auomoto/BOSS-RoboClaw-Interface/README.md

# BOSS-RoboClaw-Interface
 
Interface board that sits on top of the RoboClaw 2x7A controller with a connector for a PI motor.
