auomoto/BOSS-RoboClaw-Interface/Hardware/Eagle/BOSS-RoboClaw-Interface.pdf

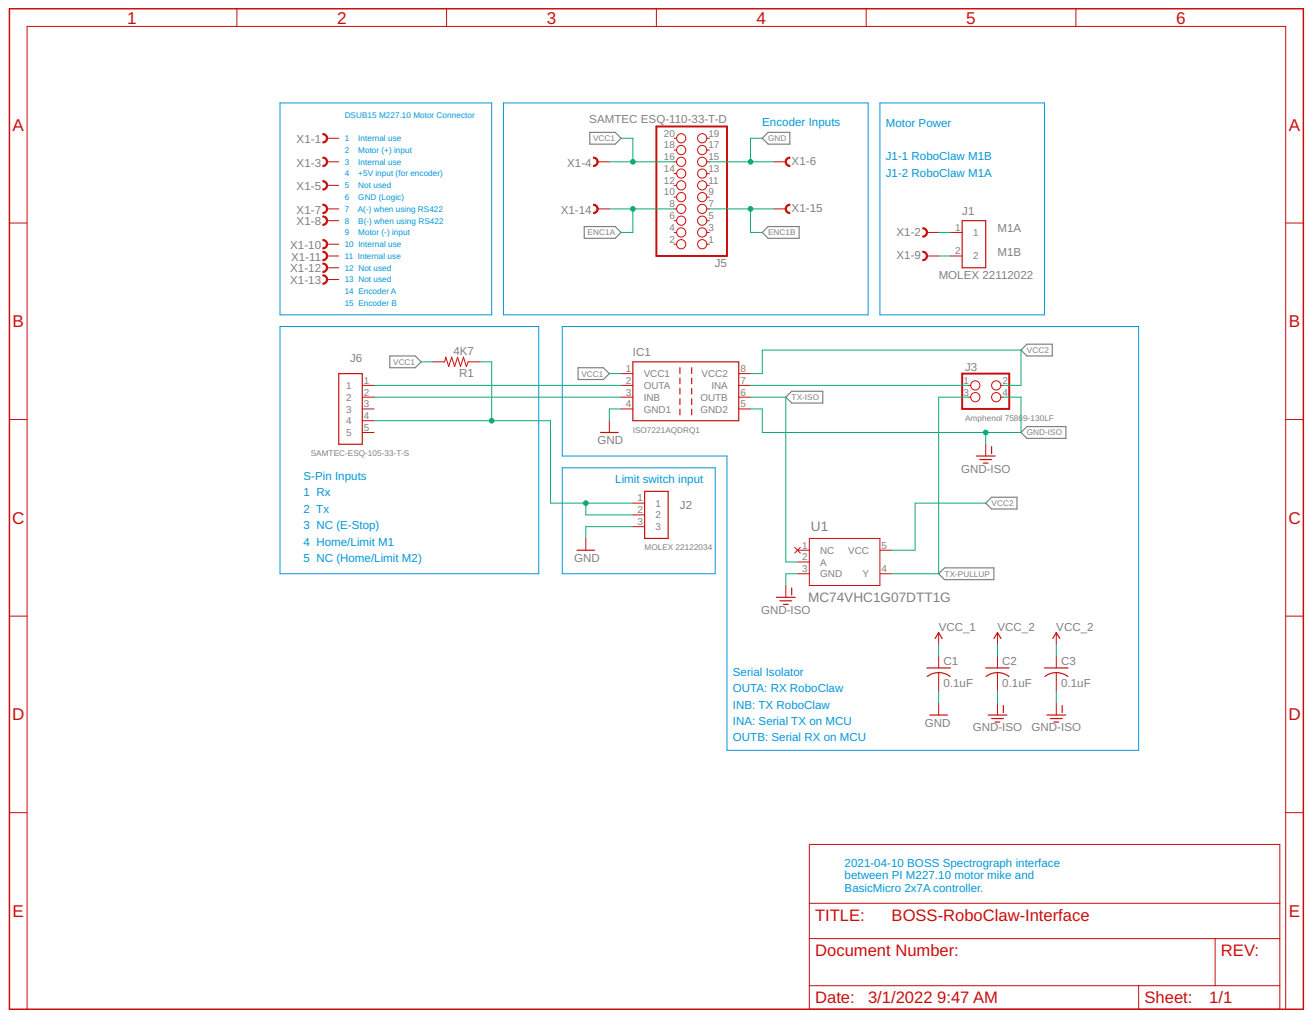
[picture p1: page 1]

Serial Isolator OUTA: RX RoboClaw

INB: TX RoboClaw
INA: Serial TX on MCU
OUTB: Serial RX on MCU

2021-04-10 BOSS Spectrograph interface
between PI M227.10 motor mike and
BasicMicro 2x7A controller.
TITLE:

Document Number: | REV:

Date: 3/1/2022 9:47 AM | Sheet: 1/1
