auomoto/BOSS-RoboClaw-Interface/Hardware/Eagle/2021-04-10 BOSS-RoboClaw-Interface.pdf

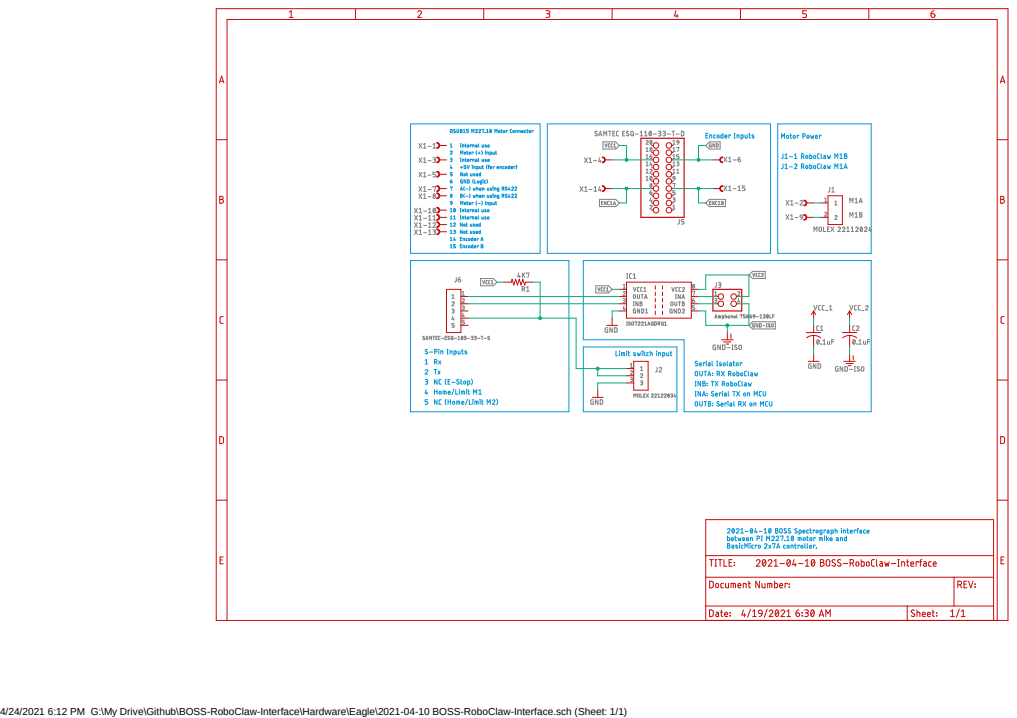
[picture p2: page 1]

4/24/2021 6:12 PM G:\My Drive\Github\BOSS-RoboClaw-Interface\Hardware\Eagle\2021-04-10 BOSS-RoboClaw-Interface.sch (Sheet: 1/1)
