auomoto/BOSS-RoboClaw-Interface/Hardware/Eagle/2020-11-23 BOSS-RoboClaw-Interface Schematic.pdf

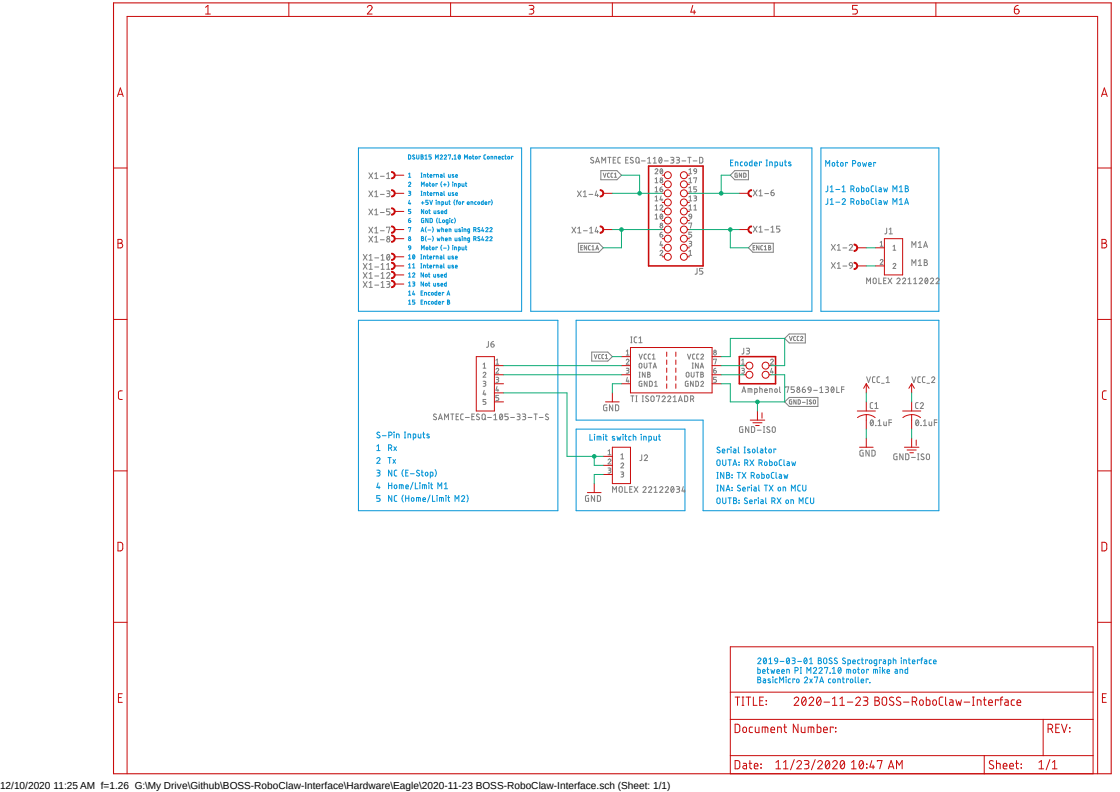
[picture p3: page 1]

12/10/2020 11:25 AM f=1.26 G:\My Drive\Github\BOSS-RoboClaw-Interface\Hardware\Eagle\2020-11-23 BOSS-RoboClaw-Interface.sch (Sheet: 1/1)
