auomoto/BOSS-RoboClaw-Interface/Hardware/Eagle/BOSS-RoboClaw-Interface.brd

## EAGLE design Hardware/Eagle/BOSS-RoboClaw-Interface.brd (2022-06-14)

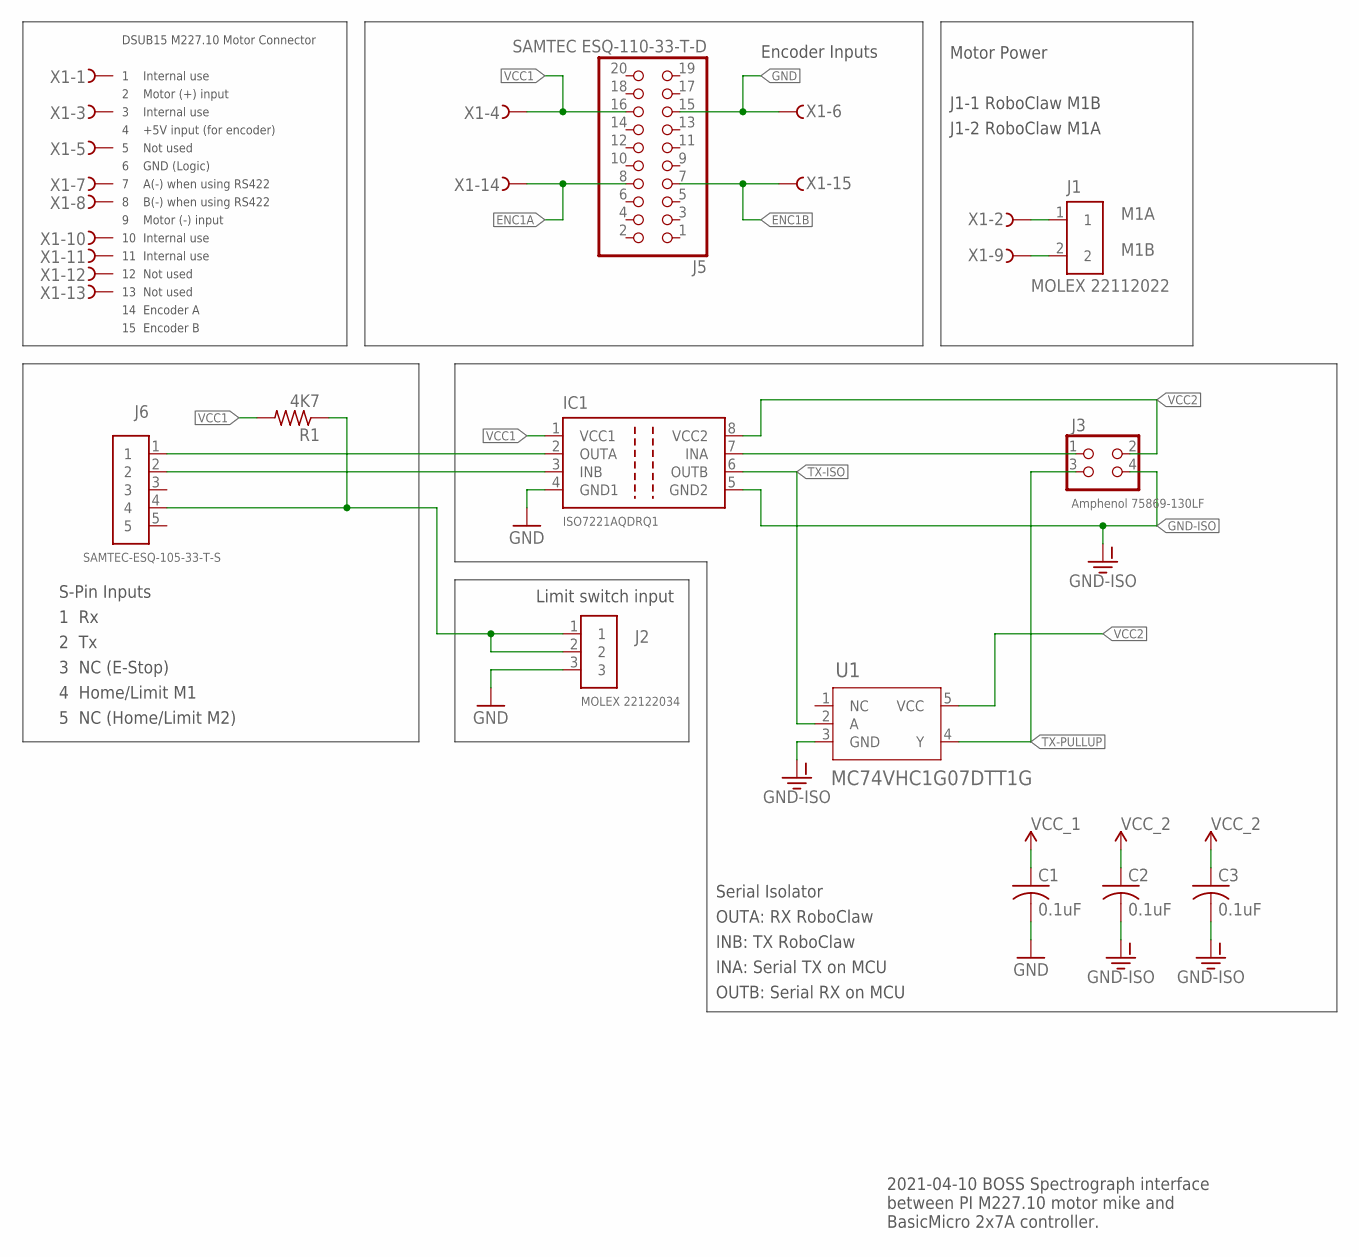
[picture p4: schematic BOSS-RoboClaw-Interface.sch]

Parts:
C1, C2, C3: 0.1uF; C0805
IC1: ISO7221AQDRQ1; SO-08-ISO7221
J1: MOLEX 22112022; 1X02-MOLEX-22112022
J2: MOLEX 22122034; 1X03RA-MOLEX-22122034
J3: Amphenol 75869-130LF; 2X02-SHROUD
J5: SAMTEC ESQ-110-33-T-D; 2X10-ESQ-110-33-T-D
J6: SAMTEC-ESQ-105-33-T-S; 1X05-ESQ-105-33-T-S
R1: 4K7; R0805
U1: MC74VHC1G07DTT1G; SOT23-5_ONS-M
X1: Amphenol L77SDAH15SOL2RM8C309; H2R15ST

Connections:
ENC1A: J5.8, X1.14
ENC1B: J5.7, X1.15
GND: C1.2, IC1.4 (GND1), J2.3, J5.15, X1.6
GND-ISO: C2.2, C3.2, IC1.5 (GND2), J3.4, U1.3 (GND)
LIMIT: J2.1, J2.2, J6.4, R1.1
M1A: J1.1, X1.2
M1B: J1.2, X1.9
ROBO-RX: IC1.2 (OUTA), J6.1
ROBO-TX: IC1.3 (INB), J6.2
RX: IC1.7 (INA), J3.1
TX-ISO: IC1.6 (OUTB), U1.2 (A)
TX-PULLUP: J3.3, U1.4 (Y)
VCC1: C1.1, IC1.1 (VCC1), J5.16, R1.2, X1.4
VCC2: C2.1, C3.1, IC1.8 (VCC2), J3.2, U1.5 (VCC)

Notes on the sheet:
DSUB15 M227.10 Motor Connector 1 Internal use 2 Motor (+) input 3 Internal use 4 +5V input (for encoder) 5 Not used 6 GND (Logic) 7 A(-) when using RS422 8 B(-) when using RS422 9 Motor (-) input 10 Internal use 11 Internal use 12 Not used 13 Not used 14 Encoder A 15 Encoder B
Motor Power J1-1 RoboClaw M1B J1-2 RoboClaw M1A
Limit switch input
S-Pin Inputs 1 Rx 2 Tx 3 NC (E-Stop) 4 Home/Limit M1 5 NC (Home/Limit M2)
Serial Isolator OUTA: RX RoboClaw INB: TX RoboClaw INA: Serial TX on MCU OUTB: Serial RX on MCU
Encoder Inputs
2021-04-10 BOSS Spectrograph interface between PI M227.10 motor mike and BasicMicro 2x7A controller.

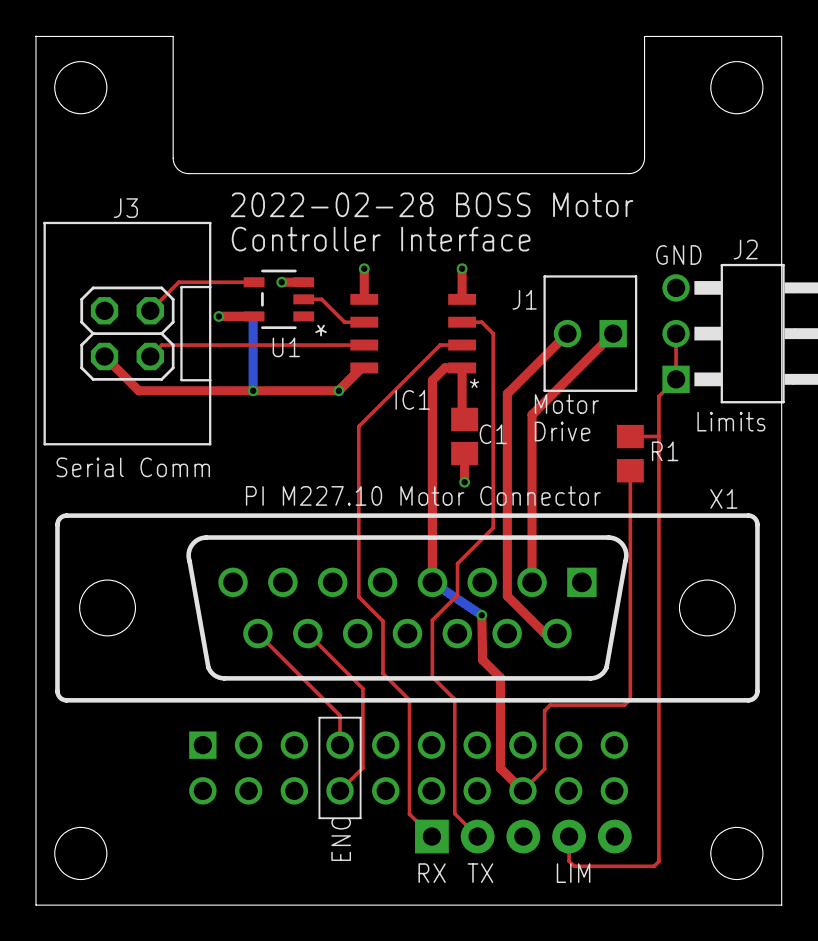
[picture p5: board BOSS-RoboClaw-Interface.brd from above]

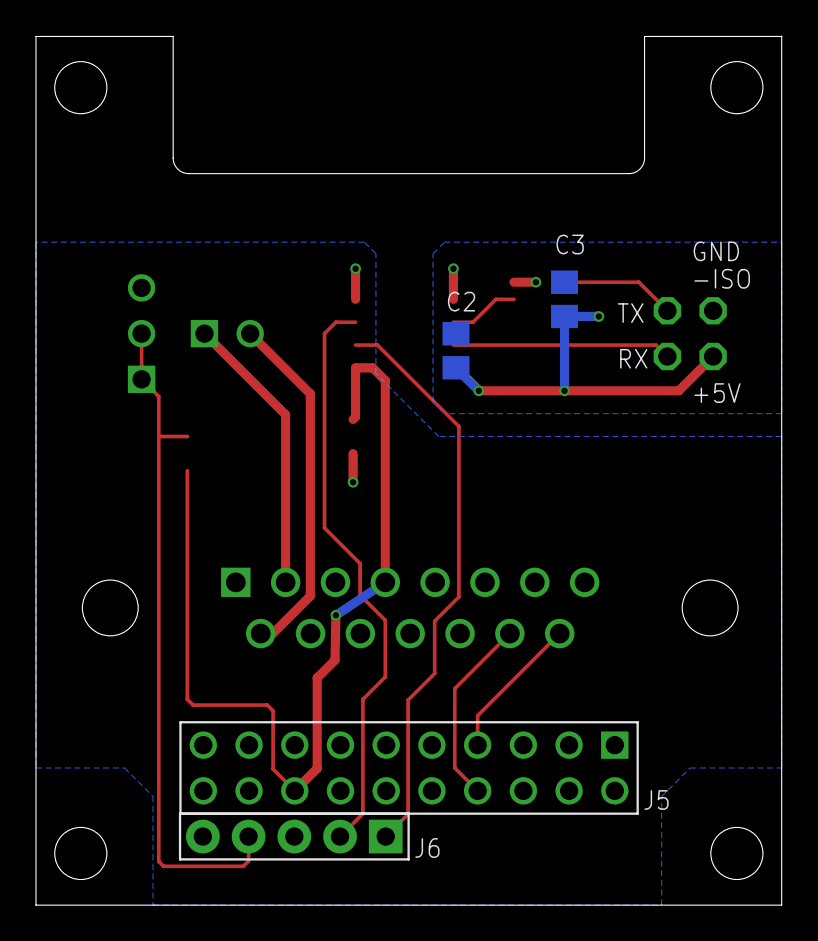
[picture p6: board BOSS-RoboClaw-Interface.brd from below]

Board: 2 copper layers, 41.4 x 48.3 mm, 12 parts (4 on the bottom side), 14 nets.
