auomoto/BOSS-RoboClaw-Interface/Hardware/Eagle/2021-04-16 BOSS-RoboClaw-Breakout.brd

## EAGLE design Hardware/Eagle/2021-04-16 BOSS-RoboClaw-Breakout.brd (2021-04-16)

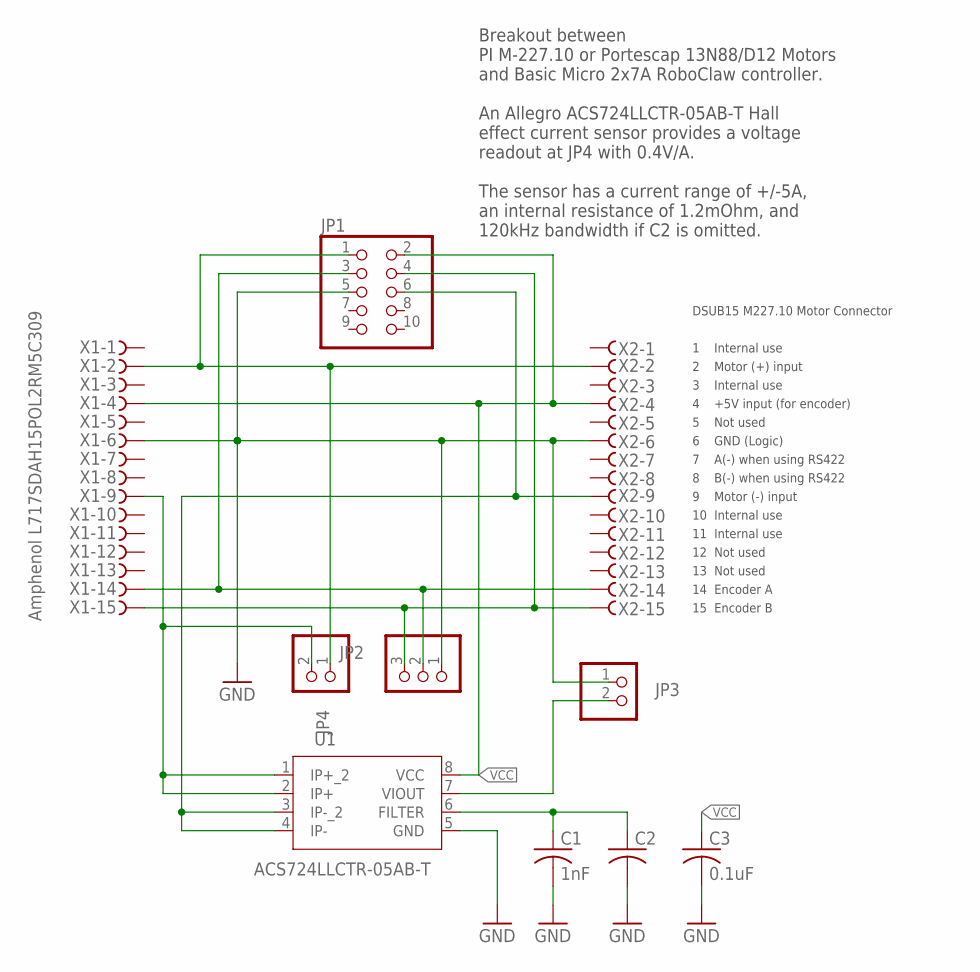
[picture p7: schematic 2021-04-16 BOSS-RoboClaw-Breakout.sch]

Parts:
C1: 1nF; C0805
C2: C-USC0805; C0805
C3: 0.1uF; C0805
JP1: PINHD-2X5; 2X05
JP2: PINHD-1X3; 1X03
JP3, JP4: PINHD-1X2; 1X02
U1: ACS724LLCTR-05AB-T; IC8_ACS724LLCTR-05AB-T_ALM
X1: Amphenol L717SDAH15POL2RM5C309; H2M15ST
X2: Amphenol L77SDAH15SOL2RM8C309; H2R15ST

Connections:
ENCA: JP1.3, JP2.2, X1.14, X2.14
ENCB: JP1.4, JP2.3, X1.15, X2.15
FILTER: C1.1, C2.1, U1.6 (FILTER)
GND: C1.2, C2.2, C3.2, JP1.5, JP2.1, JP3.1, U1.5 (GND), X1.6, X2.6
M+: JP1.1, JP4.1, X1.2, X2.2
M-: JP1.6, U1.3 (IP-_2), U1.4 (IP-), X2.9
unnamed: JP4.2, U1.1 (IP+_2), U1.2 (IP+), X1.9
VCC: C3.1, JP1.2, U1.8 (VCC), X1.4, X2.4
VIOUT: JP3.2, U1.7 (VIOUT)

Notes on the sheet:
DSUB15 M227.10 Motor Connector 1 Internal use 2 Motor (+) input 3 Internal use 4 +5V input (for encoder) 5 Not used 6 GND (Logic) 7 A(-) when using RS422 8 B(-) when using RS422 9 Motor (-) input 10 Internal use 11 Internal use 12 Not used 13 Not used 14 Encoder A 15 Encoder B
Breakout between PI M-227.10 or Portescap 13N88/D12 Motors and Basic Micro 2x7A RoboClaw controller. An Allegro ACS724LLCTR-05AB-T Hall effect current sensor provides a voltage readout at JP4 with 0.4V/A. The sensor has a current range of +/-5A, an internal resistance of 1.2mOhm, and 120kHz bandwid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

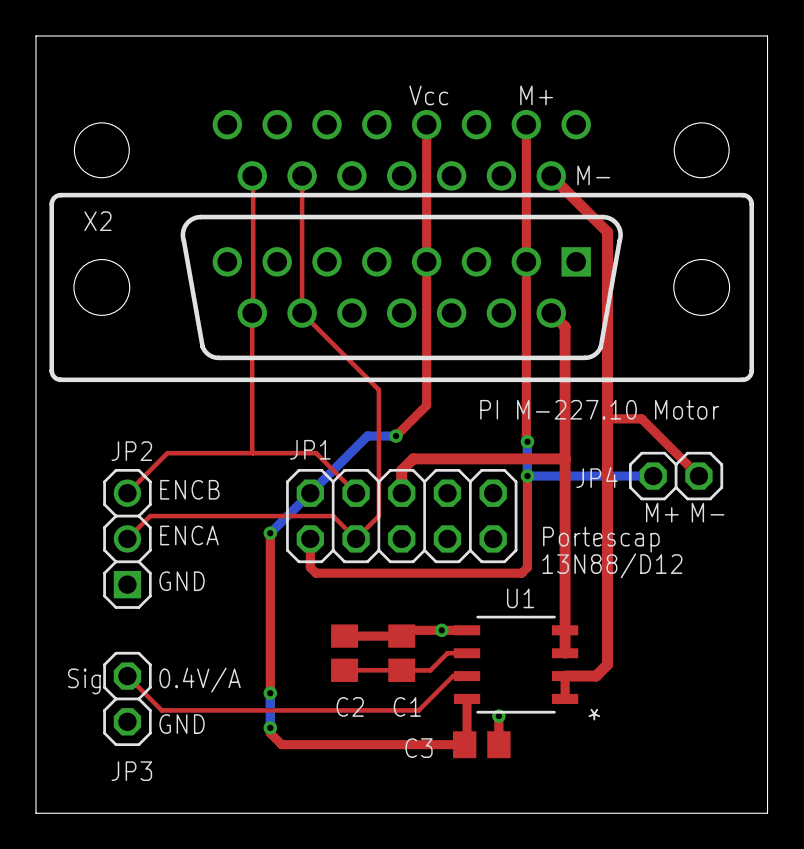
[picture p8: board 2021-04-16 BOSS-RoboClaw-Breakout.brd from above]

Board: 2 copper layers, 40.6 x 43.2 mm, 10 parts (1 on the bottom side), 9 nets.
