auomoto/BOSS-RoboClaw-Interface/Hardware/Eagle/2021-04-14 BOSS-RoboClaw-Breakout.brd

## EAGLE design Hardware/Eagle/2021-04-14 BOSS-RoboClaw-Breakout.brd (2021-04-15)

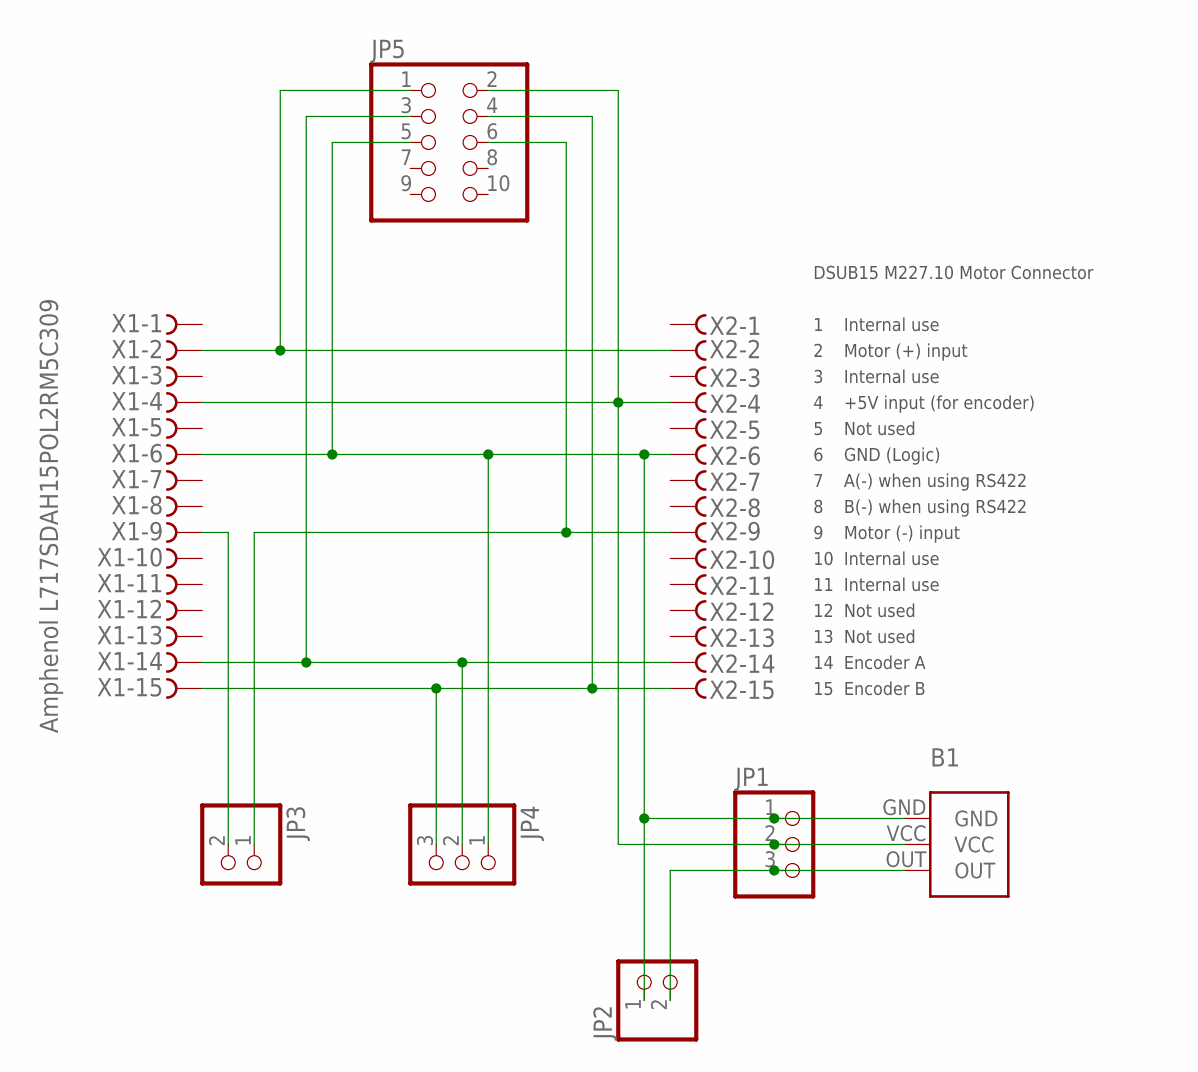
[picture p9: schematic 2021-04-14 BOSS-RoboClaw-Breakout.sch]

Parts:
B1: ACS724CARRIER
JP1, JP4: PINHD-1X3; 1X03
JP2, JP3: PINHD-1X2; 1X02
JP5: PINHD-2X5; 2X05
X1: Amphenol L717SDAH15POL2RM5C309; H2M15ST
X2: Amphenol L77SDAH15SOL2RM8C309; H2R15ST

Connections:
ENCA: JP4.2, JP5.3, X1.14, X2.14
ENCB: JP4.3, JP5.4, X1.15, X2.15
GND: B1.GND, JP1.1, JP2.1, JP4.1, JP5.5, X1.6, X2.6
M+: JP5.1, X1.2, X2.2
M-: JP3.1, JP5.6, X2.9
unnamed: JP3.2, X1.9
OUT: B1.OUT, JP1.3, JP2.2
VCC: B1.VCC, JP1.2, JP5.2, X1.4, X2.4

Notes on the sheet:
DSUB15 M227.10 Motor Connector 1 Internal use 2 Motor (+) input 3 Internal use 4 +5V input (for encoder) 5 Not used 6 GND (Logic) 7 A(-) when using RS422 8 B(-) when using RS422 9 Motor (-) input 10 Internal use 11 Internal use 12 Not used 13 Not used 14 Encoder A 15 Encoder B

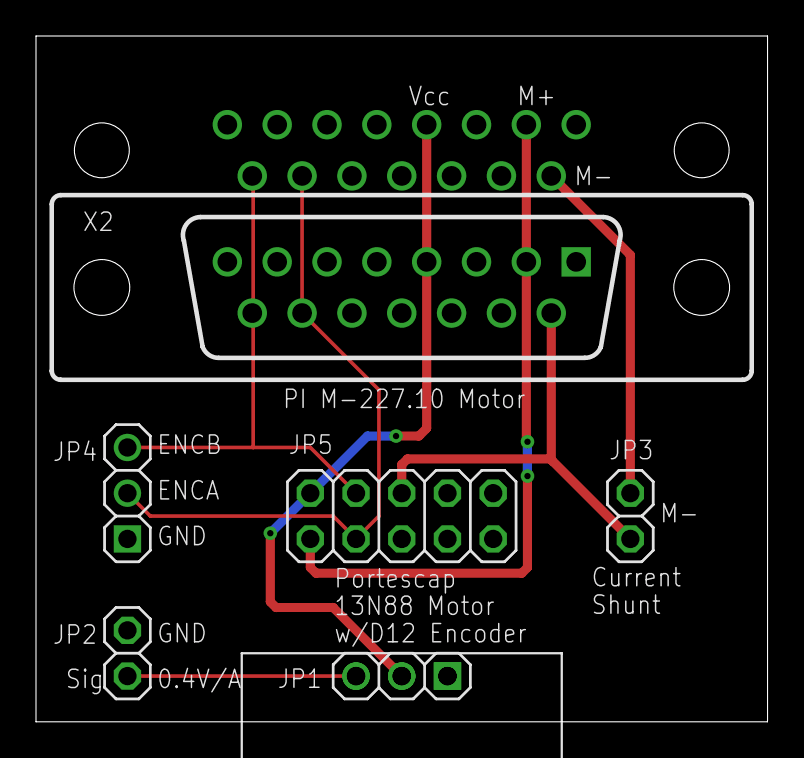
[picture p10: board 2021-04-14 BOSS-RoboClaw-Breakout.brd from above]

Board: 2 copper layers, 40.6 x 38.1 mm, 8 parts (1 on the bottom side), 8 nets.
