auomoto/BOSS-RoboClaw-Interface/Hardware/Eagle/BOSS-RoboClaw-Interface - Copy.brd

## EAGLE design Hardware/Eagle/BOSS-RoboClaw-Interface - Copy.brd (2020-11-21, an earlier design)

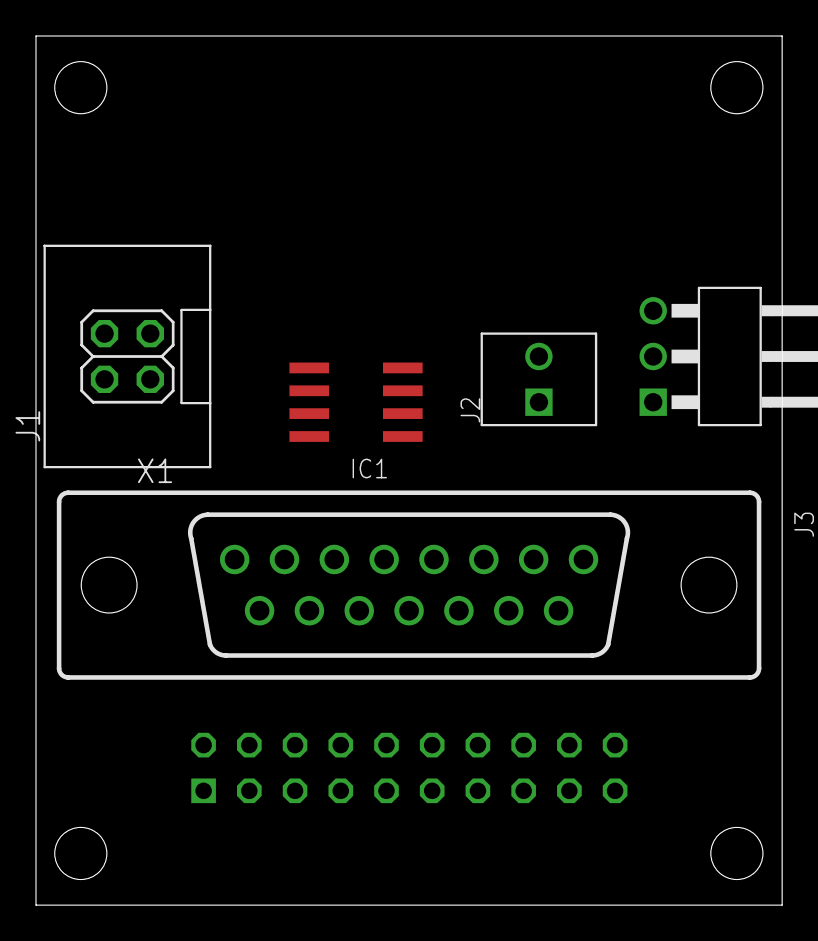
[picture p11: board BOSS-RoboClaw-Interface - Copy.brd from above]

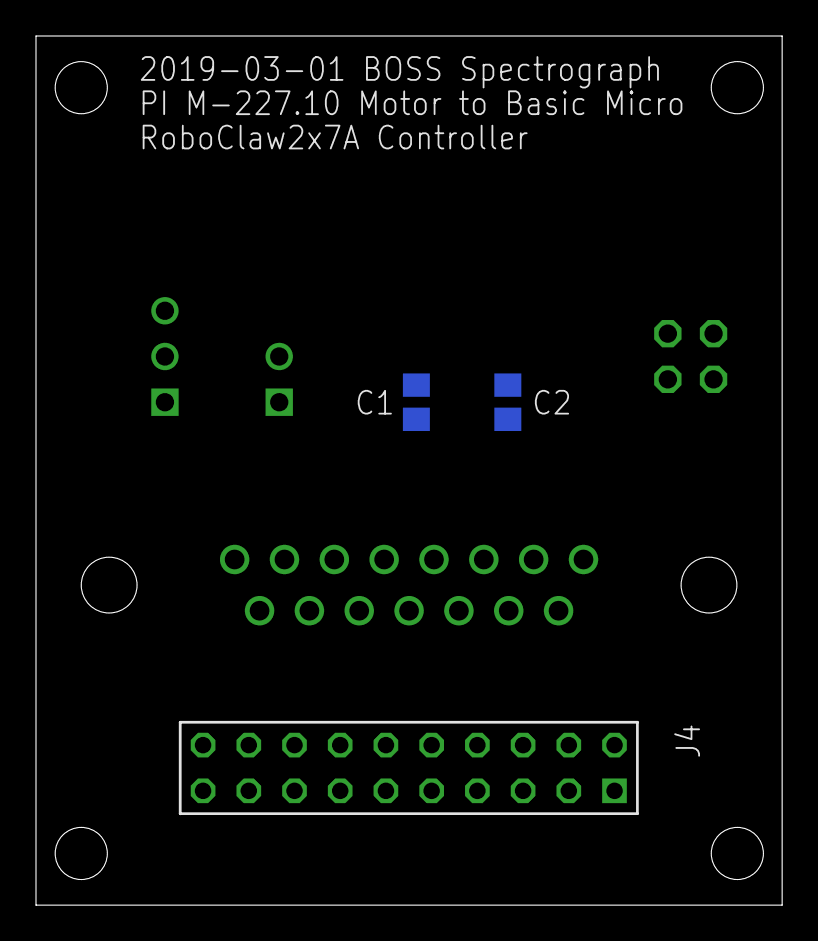
[picture p12: board BOSS-RoboClaw-Interface - Copy.brd from below]

Board: 2 copper layers, 41.5 x 48.3 mm, 8 parts (3 on the bottom side), 9 nets, no tracks yet.

Parts:
C1, C2: 0.1uF; C0805
IC1: ISO7221A; SO-08
J1: 2X02-SHROUD
J2: PINHD-1X2-MOLEX-22112022; 1X02-MOLEX-22112022
J3: Molex 22122034; 1X03RA-MOLEX-22122034
J4: FE10-2-SAMTEC-ESW-110-44-S-D
X1: Amphenol L77SDAH15SOL2RM8C309; H2R15ST

Connections:
GND: C1.2, IC1.4, J3.3, X1.6
GND-ISO: C2.2, IC1.5, J1.4
LIMIT/HOME: J3.1, J3.2
M1A: J2.2, X1.9
M1B: J2.1, X1.2
unnamed: IC1.7, J1.1
unnamed: IC1.6, J1.3
VCC1: C1.1, IC1.1, X1.4
VCC2: C2.1, IC1.8, J1.2
