auomoto/BOSS-RoboClaw-Interface/(commit log)

2020-11-21 Changed connectors and board outline to be able to use existing screw connectors
    [BOSS-RoboClaw-Interface - Copy.brd, BOSS-RoboClaw-Interface - Copy.sch]
2020-11-21 More layout changes
    [BOSS-RoboClaw-Interface.brd, BOSS-RoboClaw-Interface.sch]
2020-11-23 New headers for RoboClaw interface (need to check connections)
    [BOSS-RoboClaw-Interface.brd, BOSS-RoboClaw-Interface.sch]
2020-11-23 Swapped ENC-A and ENC-B pins to be consistent
    Also updated the board labels and changed the date to 2020-11-23.
    [BOSS-RoboClaw-Interface.brd, BOSS-RoboClaw-Interface.sch]
2020-11-23 No changes made; just saved new version
    [BOSS-RoboClaw-Interface.brd, BOSS-RoboClaw-Interface.sch]
2020-11-23 Removed sheet 2 from the schematic (old notes & BOM)
    [BOSS-RoboClaw-Interface.sch]
2020-12-10 Created schematic PDF and saved 2020-11-23 version
    [2020-11-23 BOSS-RoboClaw-Interface.brd, 2020-11-23 BOSS-RoboClaw-Interface.sch]
2021-01-11 Changed isolator chip to ISO7221AQDRQ1 from ISO7221ADR (better stock)
    [BOSS-RoboClaw-Interface.brd, BOSS-RoboClaw-Interface.sch]
2021-02-15 Increased trace width to 0.008 from 0.006 inches
    [BOSS-RoboClaw-Interface.brd]
2021-02-20 Added pullup to limit switch line
    [2021-02-15 BOSS-RoboClaw-Interface.brd, 2021-02-15 BOSS-RoboClaw-Interface.sch]
2021-02-21 Changed limit switch pullup to 4.7K
    [BOSS-RoboClaw-Interface.brd, BOSS-RoboClaw-Interface.sch]
2021-04-15 Created a motor breakout board
    [2021-03-05 RoboClaw Settings.cfg, 2021-03-05a RoboClaw Settings.cfg, 2021-04-14 BOSS-RoboClaw-Breakout.brd, 2021-04-14 BOSS-RoboClaw-Breakout.sch, BOSS-RoboClaw-Breakout.brd, BOSS-RoboClaw-Breakout.sch, BOSS-RoboClaw-Interface.brd, BOSS-RoboClaw-Interface.sch]
2021-04-16 Added motor power header pins
    [2021-04-16 BOSS-RoboClaw-Breakout.brd, 2021-04-16 BOSS-RoboClaw-Breakout.sch]
2021-04-30 Added notes to the breakout board schematic (received the breakout board today)
    [2021-04-10 BOSS-RoboClaw-Interface.brd, 2021-04-10 BOSS-RoboClaw-Interface.sch, BOSS-RoboClaw-Breakout.sch]
2021-05-06 Fixed an error in the schematic notes (J4 is motor voltage)
    [BOSS-RoboClaw-Breakout.sch]
2021-07-24 Create 2021-05-28 RoboClaw Settings.cfg
    [2021-05-28 RoboClaw Settings.cfg]
2022-06-14 Includes open drain buffer
    [BOSS-RoboClaw-Interface.brd, BOSS-RoboClaw-Interface.sch]
