auomoto/BOSS-RoboClaw-Interface/(notices)

Notices in the files:
parts and their libraries:
COPYRIGHT: Copyright (C) 2018 Accelerated Designs. All rights reserved
COPYRIGHT: Copyright (C) 2022 Ultra Librarian. All rights reserved.
